nhnifong/stringman-pcbs/gripper_hat/gripper_hat/Pasted image.png

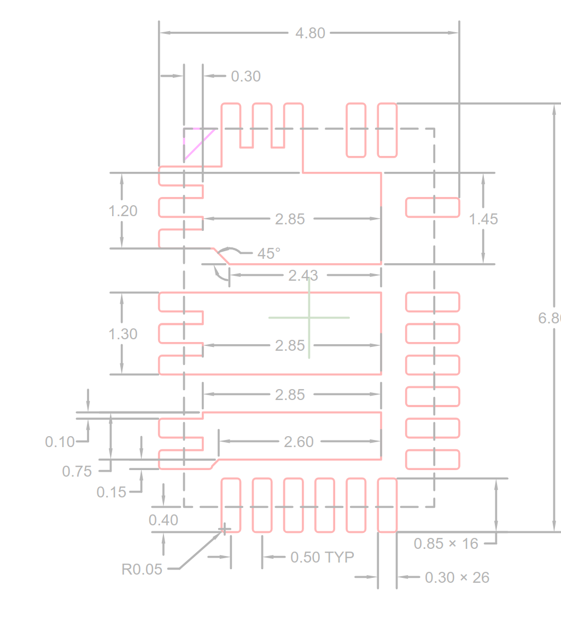
gripper_hat/gripper_hat/Pasted image.png
