nhnifong/stringman-pcbs/anchor_hat/anchor_hat/anchor_hat.kicad_pcb

## KiCad design anchor_hat/anchor_hat/anchor_hat.kicad_pcb (2026-09-18)

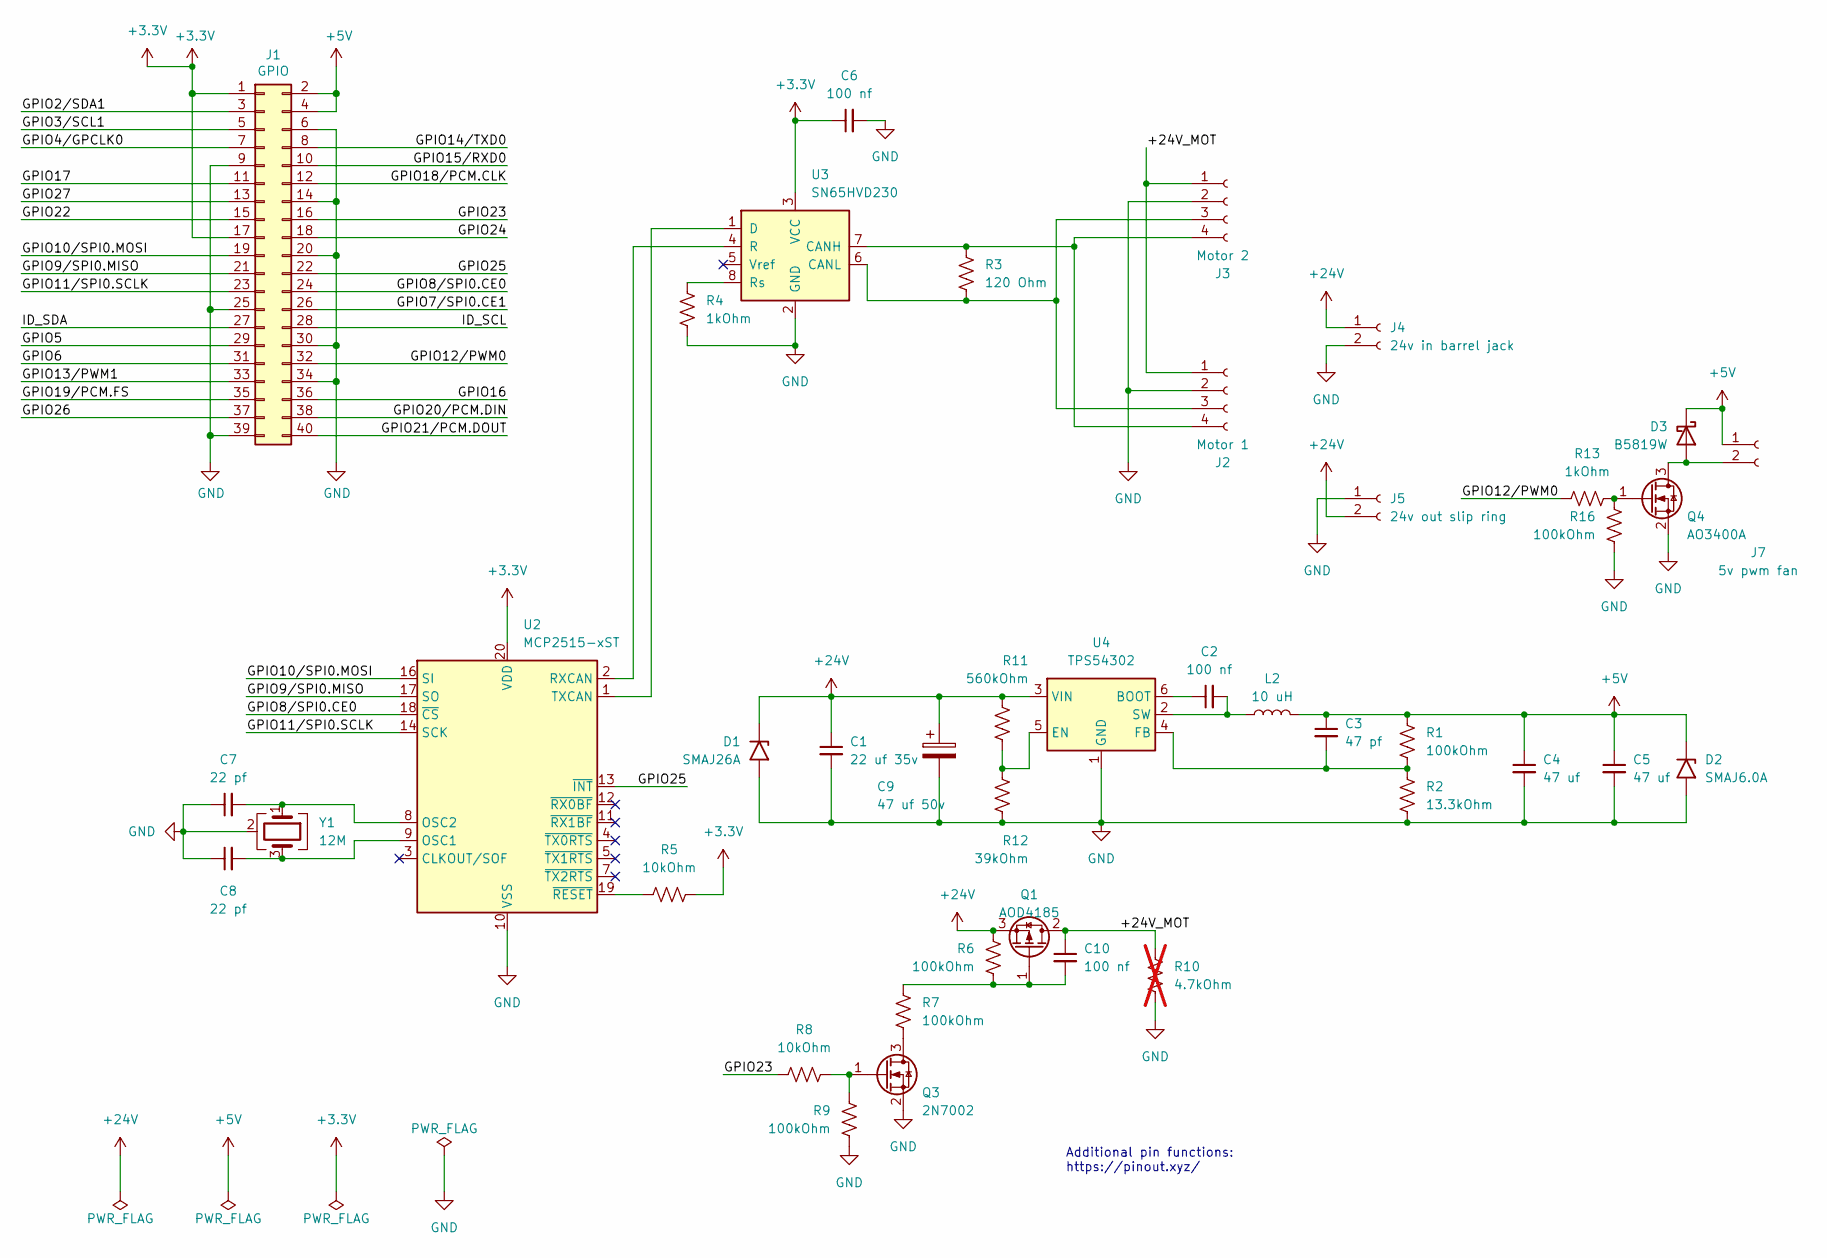
[picture p2: schematic anchor_hat.kicad_sch]

Parts:
C1: 22 uf 35v; C_1206_3216Metric
C2, C6, C10: 100 nf; C_0603_1608Metric
C3: 47 pf; C_0603_1608Metric
C4, C5: 47 uf; C_1206_3216Metric
C7, C8: 22 pf; C_0603_1608Metric
C9: 47 uf 50v; CP_Elec_6.3x7.7; jlc part C970679
D1: SMAJ26A; D_SMA; manufacturer part number SMAJ26A; jlc part C49370
D2: SMAJ6.0A; D_SMA; manufacturer part number SMAJ6.0A; jlc part C364284
D3: B5819W; D_SOD-123; manufacturer part number B5819W; jlc part C8598
J1: GPIO; PinSocket_2x20_P2.54mm_Vertical
J2: Motor 1; CONN-TH_4P-XT30PW-M; manufacturer part number XT30PW(2+2)-M.G.B; jlc part C19268030
J3: Motor 2; CONN-TH_4P-XT30PW-M; manufacturer part number XT30PW(2+2)-M.G.B; jlc part C19268030
J4: 24v in barrel jack; BarrelJack_vertical
J5: 24v out slip ring; JST_ZH_B2B-ZR-SM4-TF_1x02-1MP_P1.50mm_Vertical; jlc part C265284
J7: 5v pwm fan; JST_PH_B2B-PH-K_1x02_P2.00mm_Vertical
L2: 10 uH; IND-SMD_L8.0-W8.0_FNR80XXS; manufacturer part number FNR8040S100MT; jlc part C168127
Q1: AOD4185; TO-252-2; manufacturer part number AOD4185; jlc part C400894
Q3: 2N7002; SOT-23; manufacturer part number 2N7002; jlc part C8545
Q4: AO3400A; SOT-23; manufacturer part number AO3400A; jlc part C20917
R1, R6, R7, R9, R16: 100kOhm; R_0603_1608Metric
R2: 13.3kOhm; R_0603_1608Metric
R3: 120 Ohm; R_0603_1608Metric
R4, R13: 1kOhm; R_0603_1608Metric
R5, R8: 10kOhm; R_0603_1608Metric
R10: 4.7kOhm; R_1206_3216Metric; not fitted
R11: 560kOhm; R_0603_1608Metric
R12: 39kOhm; R_0603_1608Metric
U2: MCP2515-xST; TSSOP-20_4.4x6.5mm_P0.65mm; manufacturer part number MCP2515-I/ST; jlc part C15193
U3: SN65HVD230; SOIC-8_3.9x4.9mm_P1.27mm; manufacturer part number SN65HVD230DR; jlc part C12084
U4: TPS54302; SOT-23-6; manufacturer part number TPS54302DDCT; jlc part C311983
Y1: 12M; Crystal_SMD_3225-4Pin_3.2x2.5mm; manufacturer part number X322512MSB4SI; jlc part C9002

Connections:
+3.3V: C6.1, J1.1, J1.17, R5.2, U2.20 (VDD), U3.3 (VCC)
+5V: C3.1, C4.1, C5.1, D2.1 (A1), D3.1 (K), J1.2, J1.4, J7.1, L2.2, R1.1
+24V: C1.1, C9.1, D1.1 (A1), J4.1, J5.2, Q1.3 (S), R6.1, R11.1, U4.3 (VIN)
/+24V_MOT: C10.1, J2.1, J3.1, Q1.2 (D), R10.1
/GPIO2/SDA1: J1.3
/GPIO3/SCL1: J1.5
/GPIO4/GPCLK0: J1.7
/GPIO5: J1.29
/GPIO6: J1.31
/GPIO7/SPI0.CE1: J1.26
/GPIO8/SPI0.CE0: J1.24, U2.18 (~CS)
/GPIO9/SPI0.MISO: J1.21, U2.17 (SO)
/GPIO10/SPI0.MOSI: J1.19, U2.16 (SI)
/GPIO11/SPI0.SCLK: J1.23, U2.14 (SCK)
/GPIO12/PWM0: J1.32, R13.1
/GPIO13/PWM1: J1.33
/GPIO14/TXD0: J1.8
/GPIO15/RXD0: J1.10
/GPIO16: J1.36
/GPIO17: J1.11
/GPIO18/PCM.CLK: J1.12
/GPIO19/PCM.FS: J1.35
/GPIO20/PCM.DIN: J1.38
/GPIO21/PCM.DOUT: J1.40
/GPIO22: J1.15
/GPIO23: J1.16, R8.1
/GPIO24: J1.18
/GPIO25: J1.22, U2.13 (~INT)
/GPIO26: J1.37
/GPIO27: J1.13
/ID_SCL: J1.28
/ID_SDA: J1.27
GND: C1.2, C4.2, C5.2, C6.2, C7.1, C8.1, C9.2, D1.2 (A2), D2.2 (A2), J1.6, J1.9, J1.14, J1.20, J1.25, J1.30, J1.34, J1.39, J2.2, J3.2, J4.2, J5.1, Q3.2 (S), Q4.2 (S), R2.2, R4.2, R9.2, R10.2, R12.2, R16.2, U2.10 (VSS), U3.2 (GND), U4.1 (GND), Y1.2 (G), Y1.4 (G)
unnamed: D3.2 (A), J7.2, Q4.3 (D)
unnamed: J2.3, J3.3, R3.2, U3.6 (CANL)
unnamed: J2.4, J3.4, R3.1, U3.7 (CANH)
unnamed: C10.2, Q1.1 (G), R6.2, R7.1
unnamed: Q3.3 (D), R7.2
unnamed: Q3.1 (G), R8.2, R9.1
unnamed: Q4.1 (G), R13.2, R16.1
unnamed: C8.2, U2.9 (OSC1), Y1.3
unnamed: C7.2, U2.8 (OSC2), Y1.1
unnamed: U2.2 (RXCAN), U3.4 (R)
unnamed: U2.1 (TXCAN), U3.1 (D)
unnamed: R5.1, U2.19 (~RESET)
unnamed: R4.1, U3.8 (Rs)
unnamed: C2.1, U4.6 (BOOT)
unnamed: R11.2, R12.1, U4.5 (EN)
unnamed: C3.2, R1.2, R2.1, U4.4 (FB)
unnamed: C2.2, L2.1, U4.2 (SW)

Notes on the sheet:
Additional pin functions: https://pinout.xyz/

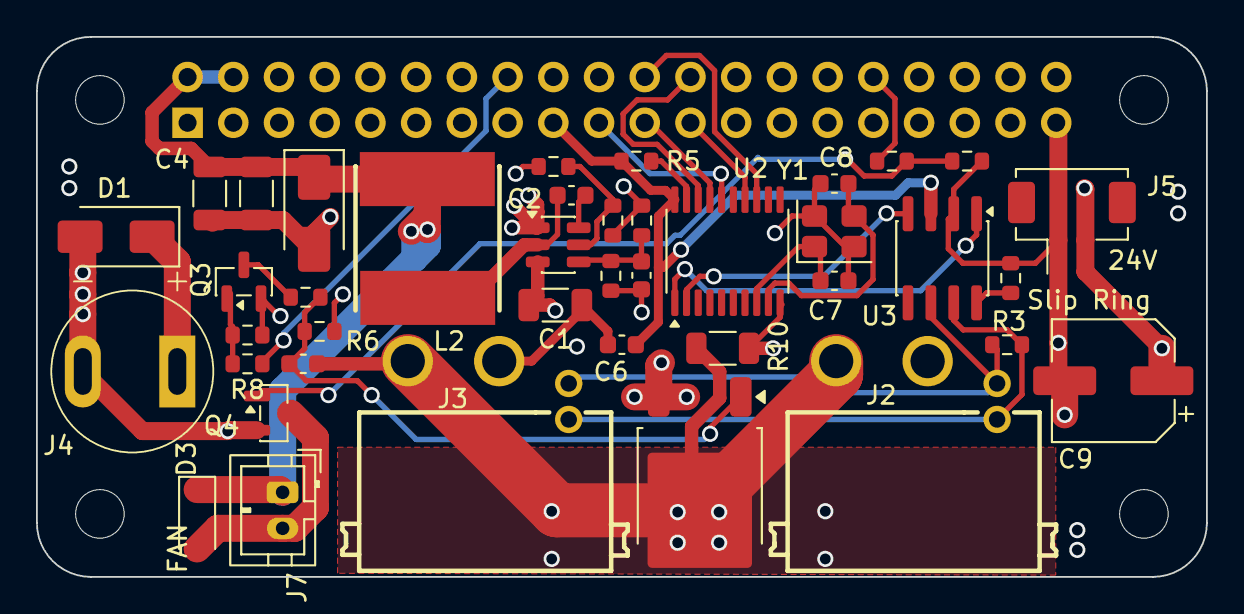
[picture p3: board anchor_hat.kicad_pcb from above]

Board: 4 copper layers, 65.0 x 30.0 mm, 45 parts (1 on the bottom side), 29 nets.

Other parts of the board:
MH1, MH2, MH3, MH4: MountingHole_2.7mm_M2.5
