nhnifong/stringman-pcbs/gripper_hat/gripper_hat/gripper_hat.kicad_pcb

## KiCad design gripper_hat/gripper_hat/gripper_hat.kicad_pcb (2026-05-27)

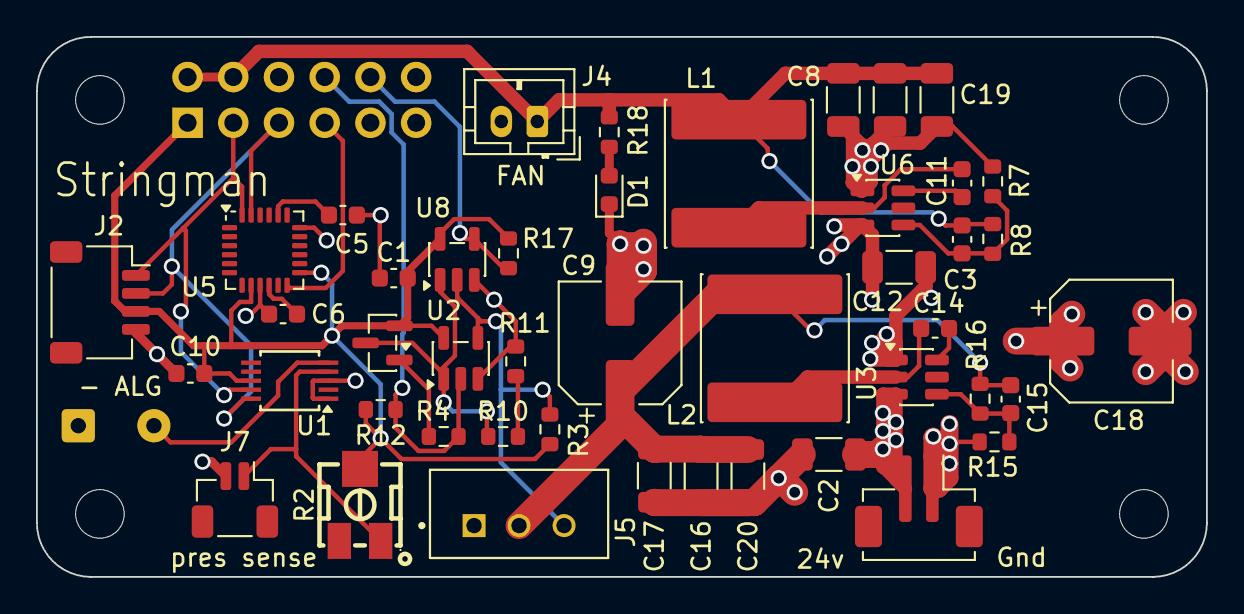
[picture p4: board gripper_hat.kicad_pcb from above]

Board: 4 copper layers, 65.0 x 30.0 mm, 51 parts (1 on the bottom side), 25 nets.

Parts:
C1, C3, C6, C10, C14: 100nf; C_0603_1608Metric
C2, C12: 10 uf; C_1206_3216Metric
C4, C8, C16, C17, C19, C20: 22 uf; C_1206_3216Metric
C5: 22nf; C_0603_1608Metric
C9, C18: 100µF; CP_Elec_6.3x7.7
C11: 47 pf; C_0603_1608Metric
C15: 100 pf; C_0603_1608Metric
D1: LED; LED_0603_1608Metric
J1: GPIO; PinSocket_2x20_P2.54mm_Vertical
J2: SM04B-SRSS-TB(LF)(SN); JST_SH_SM04B-SRSS-TB_1x04-1MP_P1.00mm_Horizontal
J3: B2B-ZR-SM4-TF(LF)(SN); JST_ZH_B2B-ZR-SM4-TF_1x02-1MP_P1.50mm_Vertical
J4: 5v for fan; JST_PH_B2B-PH-K_1x02_P2.00mm_Vertical
J5: 22035035; MOLEX_22-03-5035
J6: extra analog breakout; SolderWire-0.25sqmm_1x02_P4.2mm_D0.65mm_OD1.7mm
J7: pres 1; JST_SH_BM02B-SRSS-TB_1x02-1MP_P1.00mm_Vertical
L1, L2: 12 uh; L_Sunlord_SWPA8040S
MH1, MH2, MH3, MH4: MountingHole_2.7mm_M2.5
Q1: SS8550; SOT-23
R2: R_Variable; RES-ADJ-SMD_3P-L4.5-W4.5-P2.30-BL-FS
R3, R4, R10, R11, R12, R17: 10k; R_0603_1608Metric
R7: 13.3kOhm; R_0603_1608Metric
R8, R16: 100kOhm; R_0603_1608Metric
R15: 8.66kOhm; R_0603_1608Metric
R18: 5.1k; R_0603_1608Metric
U1: ADS1015IDGS; TSSOP-10_3x3mm_P0.5mm
U2: SN74LVC1G126DBVR; SOT-23-5
U3, U6: TPS54302; SOT-23-6
U5: MPU-6050; InvenSense_QFN-24_4x4mm_P0.5mm
U8: SN74LVC1G125DBVR; SOT-23-5

Connections:
+3V3: C1.2, C10.2, J1.1, J2.3, Q1.2 (E), R2.2, R3.2, R12.2, R17.2, U1.8 (VDD), U2.5 (VCC), U5.8 (VLOGIC), U5.13 (VDD), U8.5 (VCC)
+5V: C4.1, C8.1, C11.2, C19.1, J1.2, J1.4, J4.1, L1.2, R8.2, R18.1
+24V: C2.1, C12.1, C18.1, J3.2, U3.3 (VIN), U6.3 (VIN)
/GPIO2/SDA1: J1.3, J2.1, U1.9 (SDA), U5.24 (SDA)
/GPIO3/SCL1: J1.5, J2.2, U1.10 (SCL), U5.23 (SCL)
/GPIO4/GPCLK0: J1.7, U5.12 (INT)
/GPIO14/TXD0: J1.8, R4.2, R12.1, U2.2
/GPIO15/RXD0: J1.10, R17.1, U8.4
GND: C1.1, C2.2, C4.2, C5.2, C6.2, C8.2, C9.2, C10.1, C12.2, C16.2, C17.2, C18.2, C19.2, C20.2, D1.1 (K), J1.6, J1.9, J2.4, J3.1, J4.2, J5.1, J6.1, J7.2, R7.1, R11.2, R15.1, U1.1 (ADDR), U1.3 (GND), U2.3 (GND), U3.1 (GND), U5.9 (AD0), U5.18 (GND), U6.1 (GND), U8.3 (GND)
unnamed: D1.2 (A), R18.2
unnamed: C9.1, C15.2, C16.1, C17.1, C20.1, J5.2, L2.2, R16.2
unnamed: J5.3, R3.1, U2.4, U8.2
unnamed: J6.2, U1.5 (AIN1)
unnamed: J7.1, R2.1, U1.4 (AIN0)
unnamed: Q1.1 (B), R4.1
unnamed: Q1.3 (C), R10.2, U2.1, U8.1
unnamed: R10.1, R11.1
unnamed: C14.1, U3.6 (BOOT)
unnamed: C15.1, R15.2, R16.1, U3.4 (FB)
unnamed: C14.2, L2.1, U3.2 (SW)
unnamed: C5.1, U5.20 (CPOUT)
unnamed: C6.1, U5.10 (REGOUT)
unnamed: C3.1, U6.6 (BOOT)
unnamed: C11.1, R7.2, R8.1, U6.4 (FB)
unnamed: C3.2, L1.1, U6.2 (SW)
