nhnifong/stringman-pcbs/(commit log)

2026-04-11 actual gripper hat that is being used
    [anchor_hat-B_Cu.gbl, anchor_hat-B_Mask.gbs, anchor_hat-F_Cu.gtl, anchor_hat-F_Mask.gts, anchor_hat-F_Paste.gtp, anchor_hat-F_Silkscreen.gto, anchor_hat-PTH.drl, anchor_hat_cpl_top.csv]
2026-05-27 add pot to gripper hat pressure sense divider
    [gripper_hat-B_Cu.gbl, gripper_hat-B_Mask.gbs, gripper_hat-B_Paste.gbp, gripper_hat-B_Silkscreen.gbo, gripper_hat-Edge_Cuts.gm1, gripper_hat-F_Cu.gtl, gripper_hat-F_Mask.gts, gripper_hat-F_Paste.gtp]
2026-06-15 add pinheader for alt fan plug type
    [anchor_hat-B_Cu.gbl, anchor_hat-B_Mask.gbs, anchor_hat-B_Paste.gbp, anchor_hat-B_Silkscreen.gbo, anchor_hat-Edge_Cuts.gm1, anchor_hat-F_Cu.gtl, anchor_hat-F_Mask.gts, anchor_hat-F_Paste.gtp]
2026-07-02 swap terminals on slip ring plug so ground is the lower pin
    [anchor_hat.kicad_pcb, anchor_hat.kicad_sch]
2026-07-11 add elec cap to 24v rail on anchors
    [anchor_hat.kicad_pcb, anchor_hat.kicad_sch]
2026-09-03 fix this mess of zip files
    [anchor_hat-B_Cu.gbl, anchor_hat-B_Mask.gbs, anchor_hat-B_Paste.gbp, anchor_hat-B_Silkscreen.gbo, anchor_hat-Edge_Cuts.gm1, anchor_hat-F_Cu.gtl, anchor_hat-F_Mask.gts, anchor_hat-F_Paste.gtp]
2026-09-03 add schematic read/render helper scripts to the kicad-schematic skill
    The skill describes the loop -- read the netlist, render the sheet, look at
    it, iterate -- but ships no tooling for it, so every task re-derives the same
    scaffolding before any real work starts.
    schdump.py prints placed symbols, wires, junctions and labels with millimetre
    coordinates, optionally filtered to a rectangle, so you can see where the rails
    run and which grid points are free. schview.sh renders the sheet to PNG and
    crops regions by those same coordinates.
    The README records the things that are easy to get wrong and expensive to
    rediscover: sheet space has y down while library symbol space has y up, a
    symbol at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
2026-09-03 anchor hat: tvs clamps, gpio-switchable motor rail, buck uvlo, smaller crystal
    TVS diodes on both sides of the buck. D1 (SMAJ26A, C49370) clamps the 24V
    input, D2 (SMAJ6.0A, C364284) the 5V output; both unidirectional, cathode to
    the rail. D2 is 6.0A rather than 5.0A because R1/R2 against the TPS54302's
    0.596V reference put the rail at 5.08V, above an SMAJ5.0A's standoff, which
    would leave it leaking continuously.
    Motor rail is switchable from GPIO23. Q1 (AOD4185) is a high-side P-FET
    feeding a new +24V_MOT net supplying only J2 and J3; J4, J5 and the buck stay
    on +24V so the Pi keeps power. Q3 level-shifts the GPIO, R6/R7 clamp Vgs to
    about -12V (the FET's limit is +/-20V, and pulling the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
    [anchor_hat.kicad_sch]
2026-09-03 note kicad schematic gotchas found while wiring the anchor hat
    Each of these cost real debugging time and none is obvious from the file
    format: wires must be split at every pin they touch, field text angle adds to
    the symbol rotation, rotation and mirror pin mapping is worth measuring with
    probe labels rather than deriving, power symbols take their net name from the
    Value field, and a library symbol must be copied into lib_symbols verbatim
    rather than rebuilt from a property whitelist.
    Claude-Session: https://claude.ai/code/session_011o3vJPykXRkMivW79T9ddF
2026-09-03 Layout board with mosfet, pwm fan
    [anchor_hat.kicad_pcb, anchor_hat.kicad_sch]
2026-09-07 V4 of anchor hat
    [anchor_hat-B_Cu.gbl, anchor_hat-B_Mask.gbs, anchor_hat-B_Paste.gbp, anchor_hat-B_Silkscreen.gbo, anchor_hat-Edge_Cuts.gm1, anchor_hat-F_Cu.gtl, anchor_hat-F_Mask.gts, anchor_hat-F_Paste.gtp]
2026-09-18 replace 4 wire fan with 2 wire fan and pwm control
    [anchor_hat.kicad_pcb, anchor_hat.kicad_sch]
